Ilikemining1/HighAltitudeBallooningBoard/3D Render.png

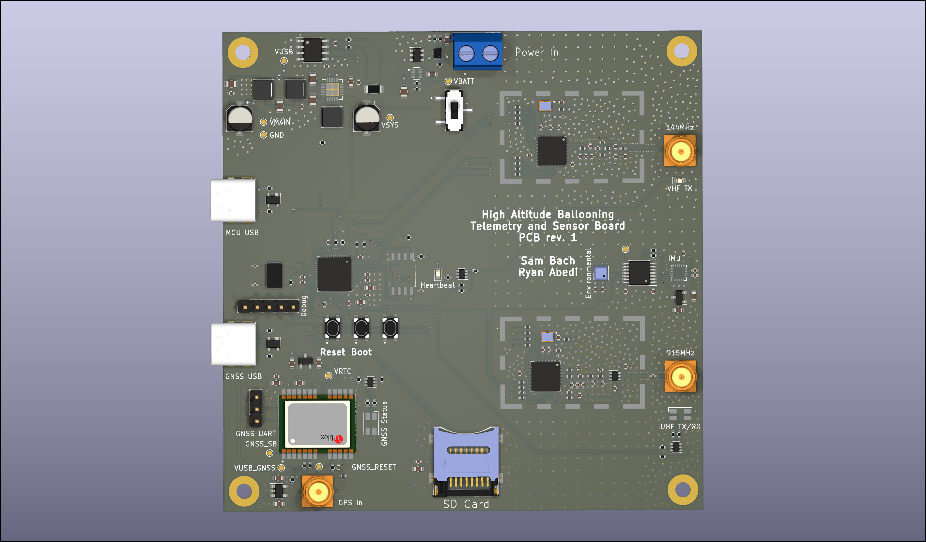
3D Render.png
