Ilikemining1/HighAltitudeBallooningBoard/HABBoard/I2C Bus Config.md

# I2C Bus Address Allocation

| Device	|	I<sup>2</sup>C Address |
|---|---|
| INA219 | 0x40 |
| NEO-M9N |	0x42 |
| BME688 | 0x77 |
| ICM-20948 | 0x69 |
