Ilikemining1/HighAltitudeBallooningBoard/HABBoard/3D/XFL4020-102MEC--3DModel-STEP-56544.STEP

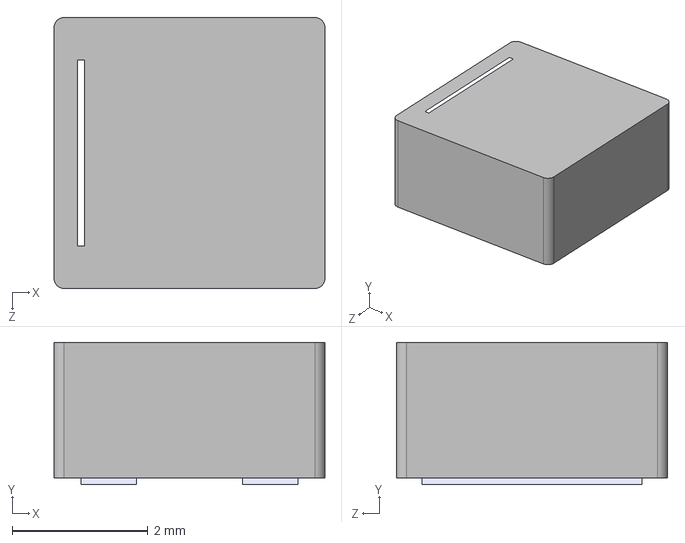
[picture p2: CAD file, 2023-02-09]
HABBoard/3D/XFL4020-102MEC--3DModel-STEP-56544.STEP
4.00 x 2.10 x 4.00 mm
