Ilikemining1/HighAltitudeBallooningBoard/HABBoard/3D/BME688--3DModel-STEP-56544.STEP

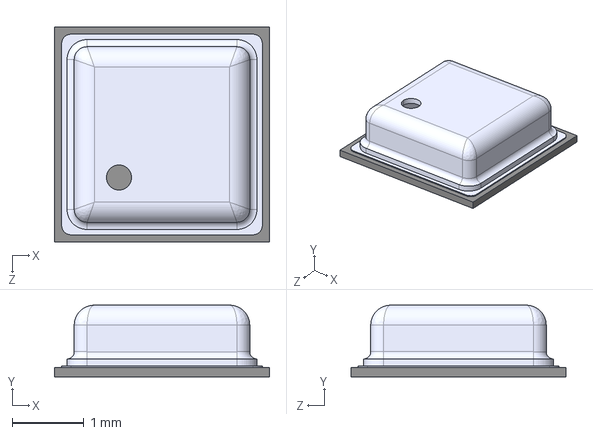
[picture p3: CAD file, 2023-02-09]
HABBoard/3D/BME688--3DModel-STEP-56544.STEP
3.00 x 1.00 x 3.00 mm
