Ilikemining1/HighAltitudeBallooningBoard/HABBoard/3D/USB4085-GF-A.stp

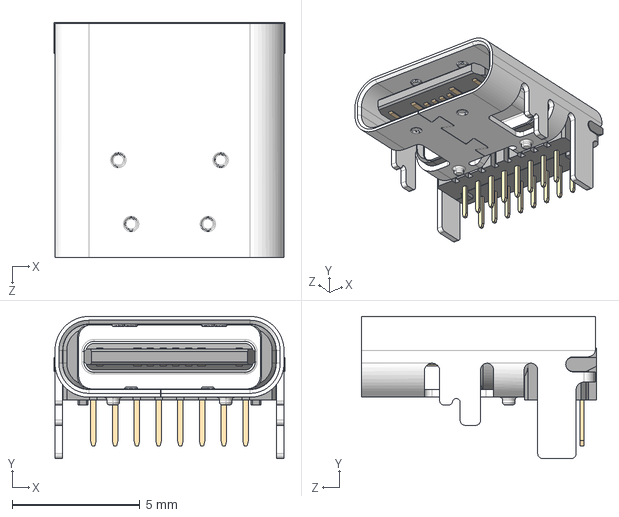
[picture p4: CAD file, 2023-02-08]
HABBoard/3D/USB4085-GF-A.stp
9.03 x 5.56 x 9.17 mm
housing_2
