Ilikemining1/HighAltitudeBallooningBoard/HABBoard/3D/CUI_DEVICES_TB002-500-02BE.step

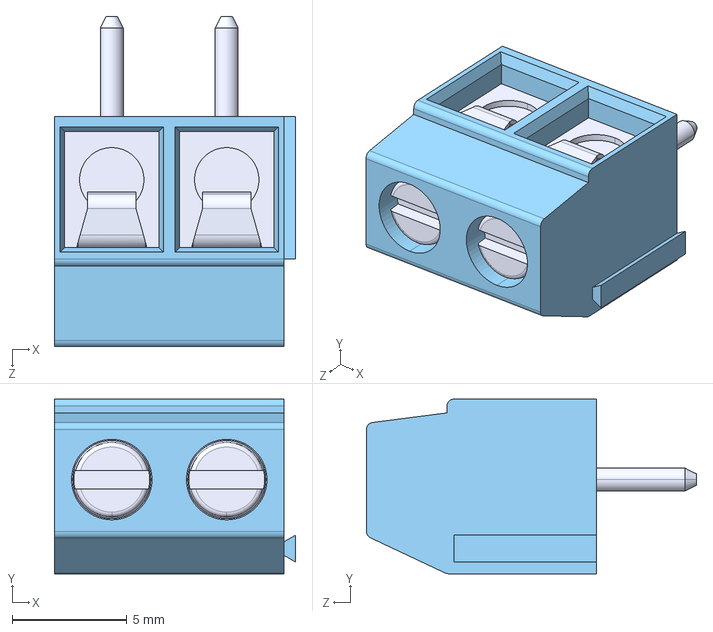
[picture p5: CAD file, 2023-02-07]
HABBoard/3D/CUI_DEVICES_TB002-500-02BE.step
10.5 x 7.60 x 14.4 mm
