Ilikemining1/HighAltitudeBallooningBoard/HABBoard/3D/SMA_CONNECTOR.step

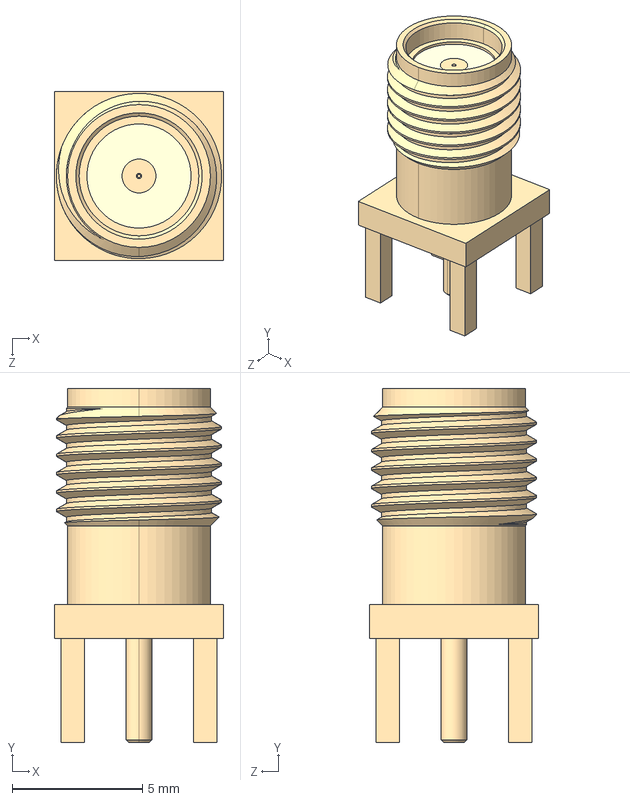
[picture p6: CAD file, 2023-02-07]
HABBoard/3D/SMA_CONNECTOR.step
6.50 x 13.6 x 6.50 mm
