Ilikemining1/HighAltitudeBallooningBoard/HABBoard/3D/445C25D12M00000.stp

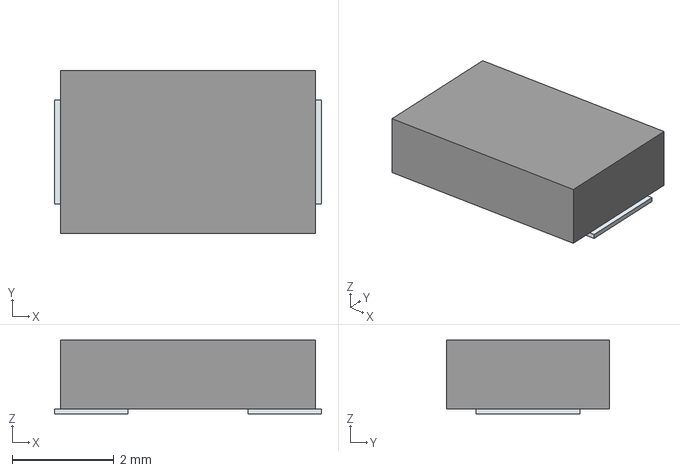
[picture p7: CAD file, 2023-02-06]
HABBoard/3D/445C25D12M00000.stp
5.24 x 3.20 x 1.45 mm
Pins
