Ilikemining1/HighAltitudeBallooningBoard/HABBoard/3D/u-blox_-_NEO-M9N-00B.step

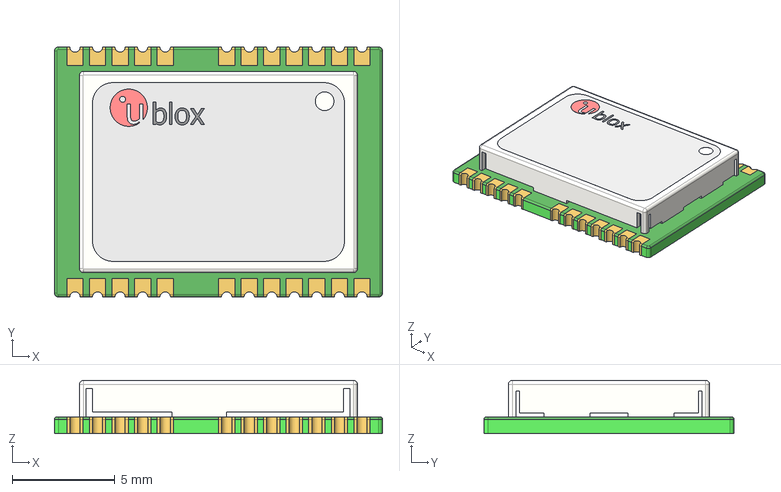
[picture p8: CAD file, 2023-02-06]
HABBoard/3D/u-blox_-_NEO-M9N-00B.step
16.0 x 12.2 x 2.60 mm
