Ilikemining1/HighAltitudeBallooningBoard/HABBoard/3D/PTS815_SJK_250_SMTR_LFS.stp

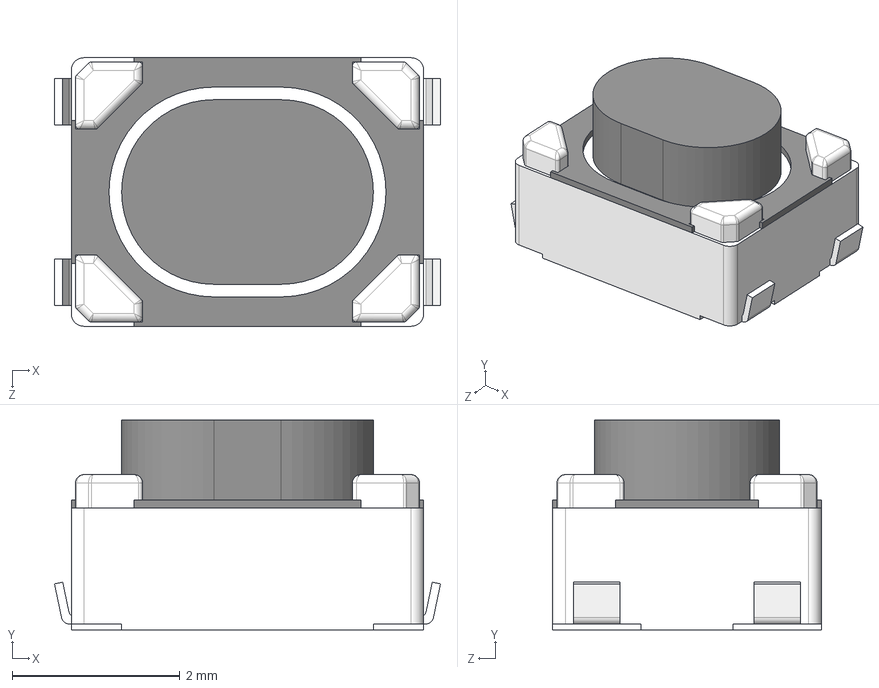
[picture p9: CAD file, 2023-02-06]
HABBoard/3D/PTS815_SJK_250_SMTR_LFS.stp
4.60 x 2.50 x 3.20 mm
