Ilikemining1/HighAltitudeBallooningBoard/HABBoard/3D/MP5016GQH.step

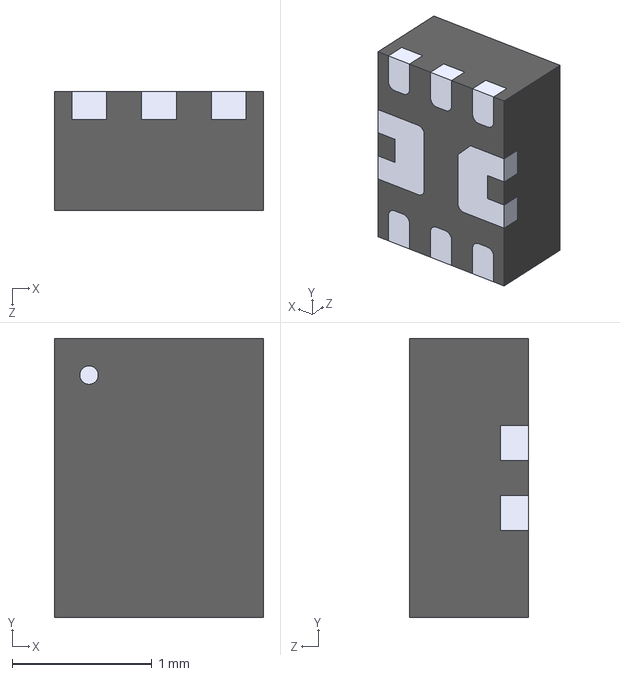
[picture p10: CAD file, 2023-02-06]
HABBoard/3D/MP5016GQH.step
1.50 x 2.00 x 0.85 mm
