Ilikemining1/HighAltitudeBallooningBoard/HABBoard/3D/MEM2067-02-180-00-A_REVB.step

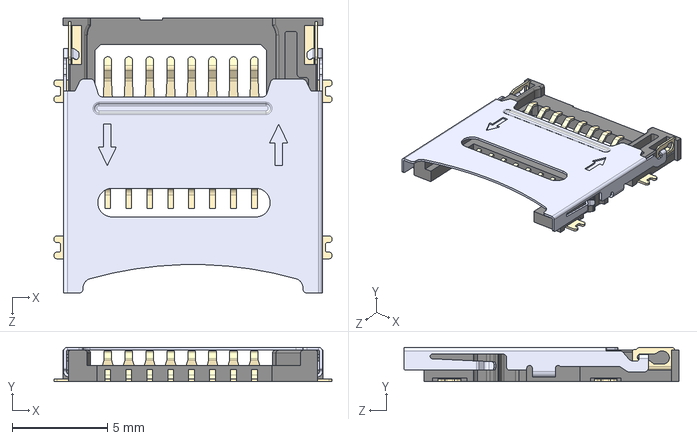
[picture p11: CAD file, 2023-02-05]
HABBoard/3D/MEM2067-02-180-00-A_REVB.step
14.6 x 1.80 x 14.5 mm
