Ilikemining1/HighAltitudeBallooningBoard/HABBoard/3D/ECS-TXO-25CSMV-320-BM-TR.step

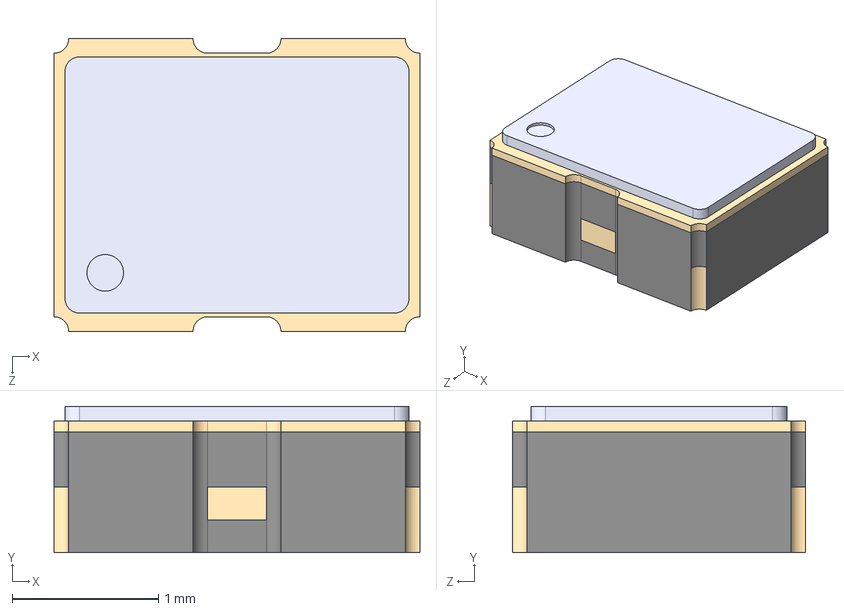
[picture p12: CAD file, 2023-01-26]
HABBoard/3D/ECS-TXO-25CSMV-320-BM-TR.step
2.50 x 1.00 x 2.00 mm
