Ilikemining1/HighAltitudeBallooningBoard/HABBoard/3D/JS102011SCQN.step

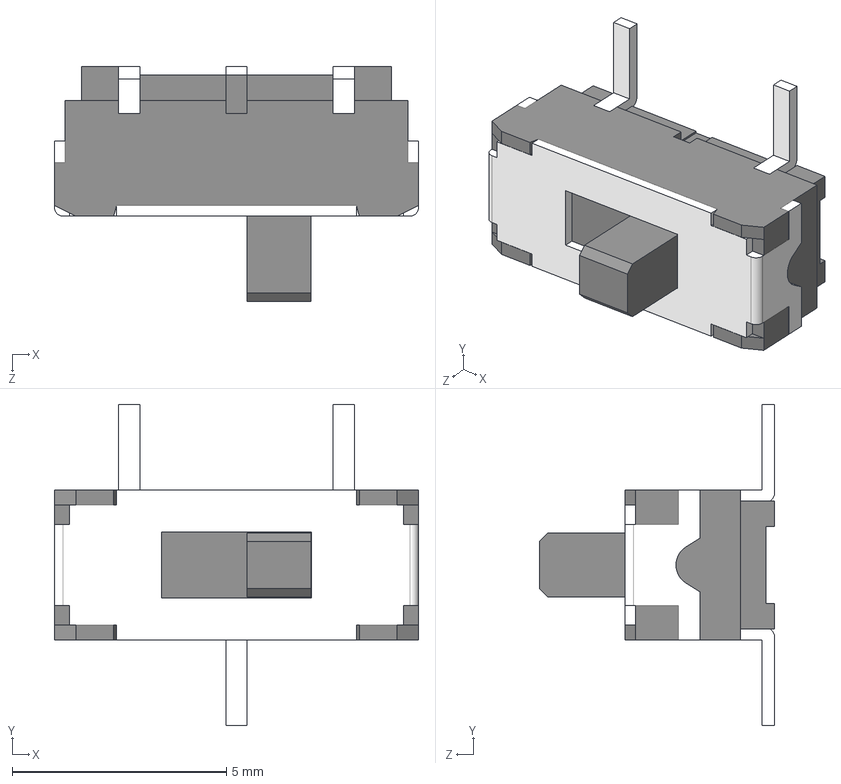
[picture p13: CAD file, 2023-02-05]
HABBoard/3D/JS102011SCQN.step
8.50 x 7.50 x 5.50 mm
