Ilikemining1/HighAltitudeBallooningBoard/Board Copper.pdf

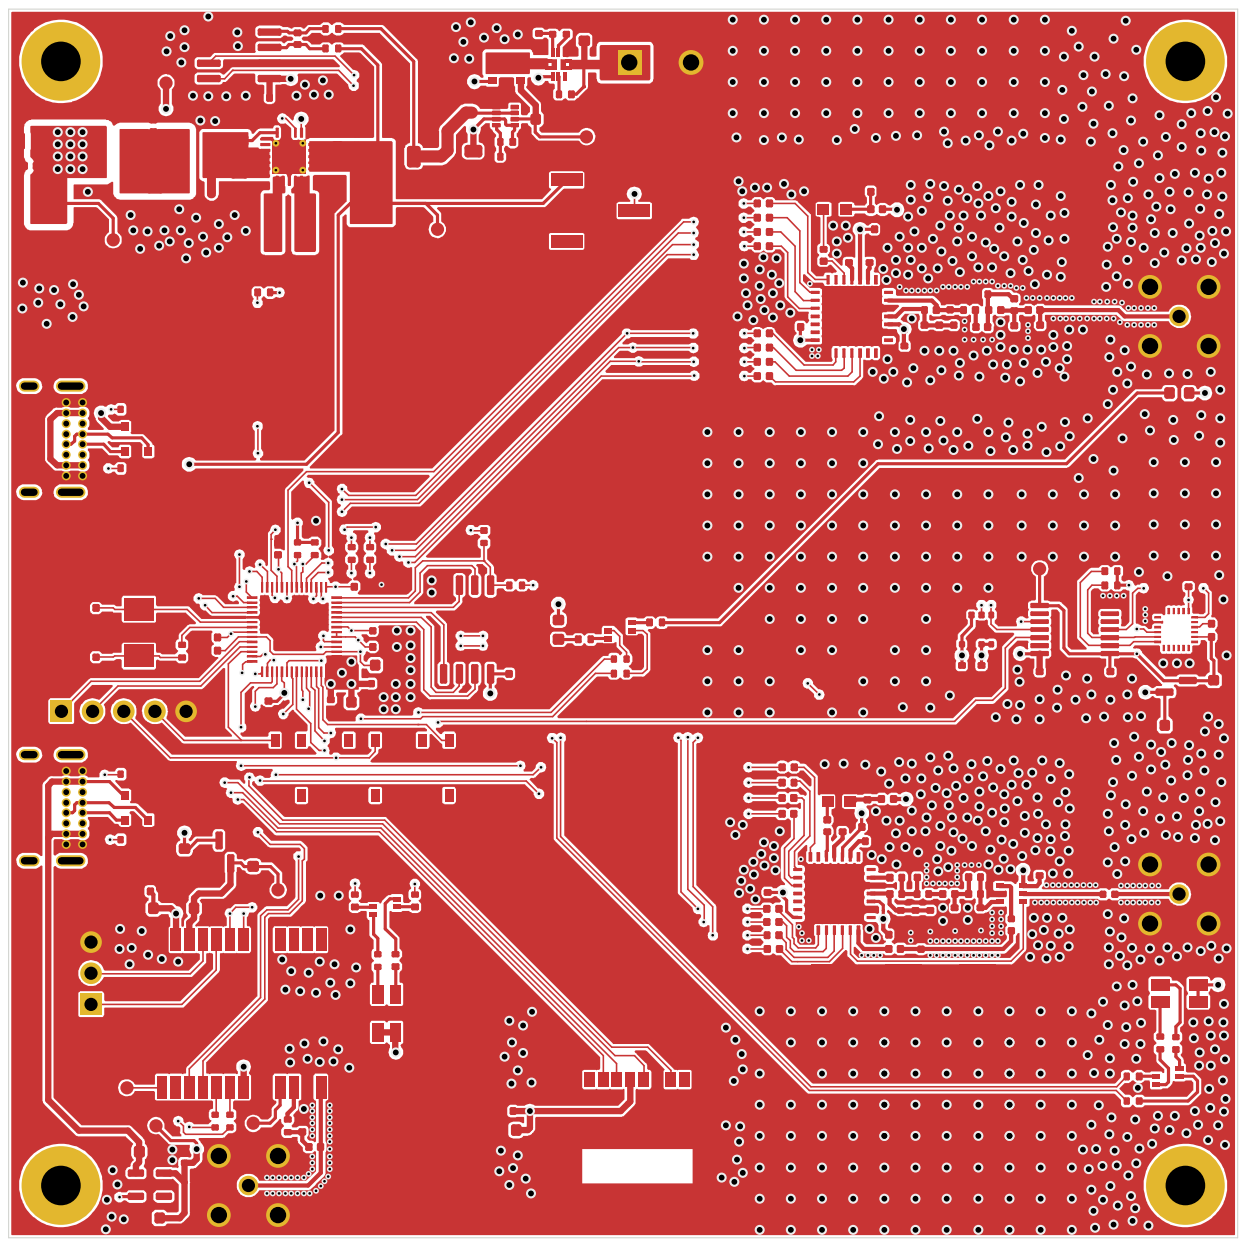
[picture p15: page 1]

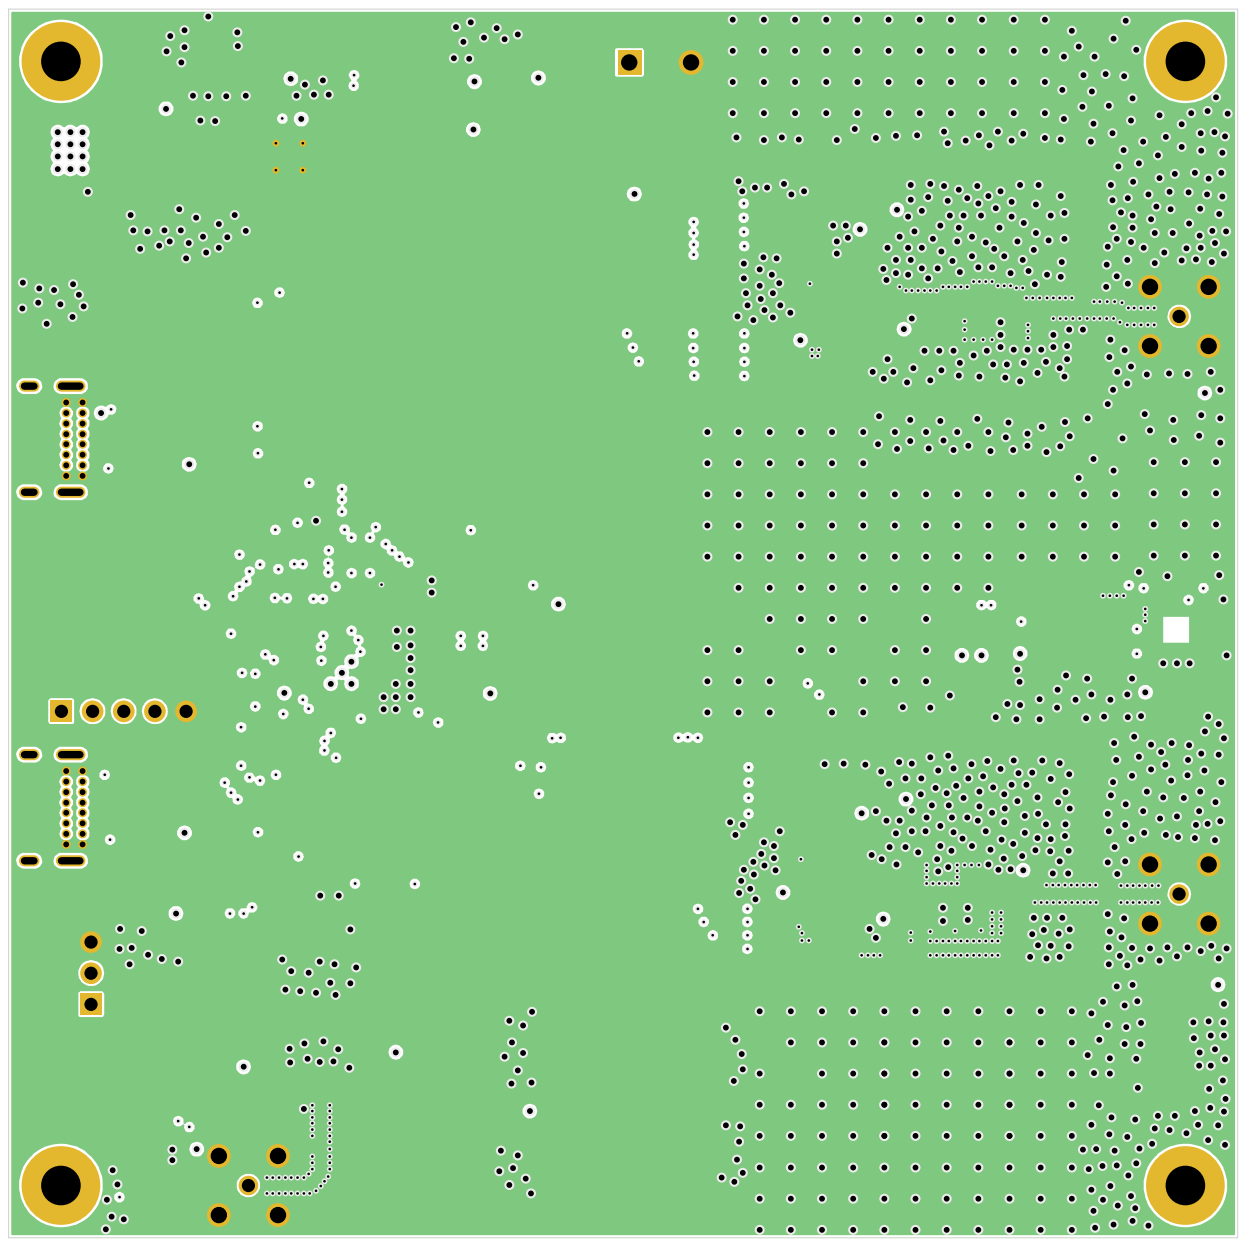
[picture p16: page 2]

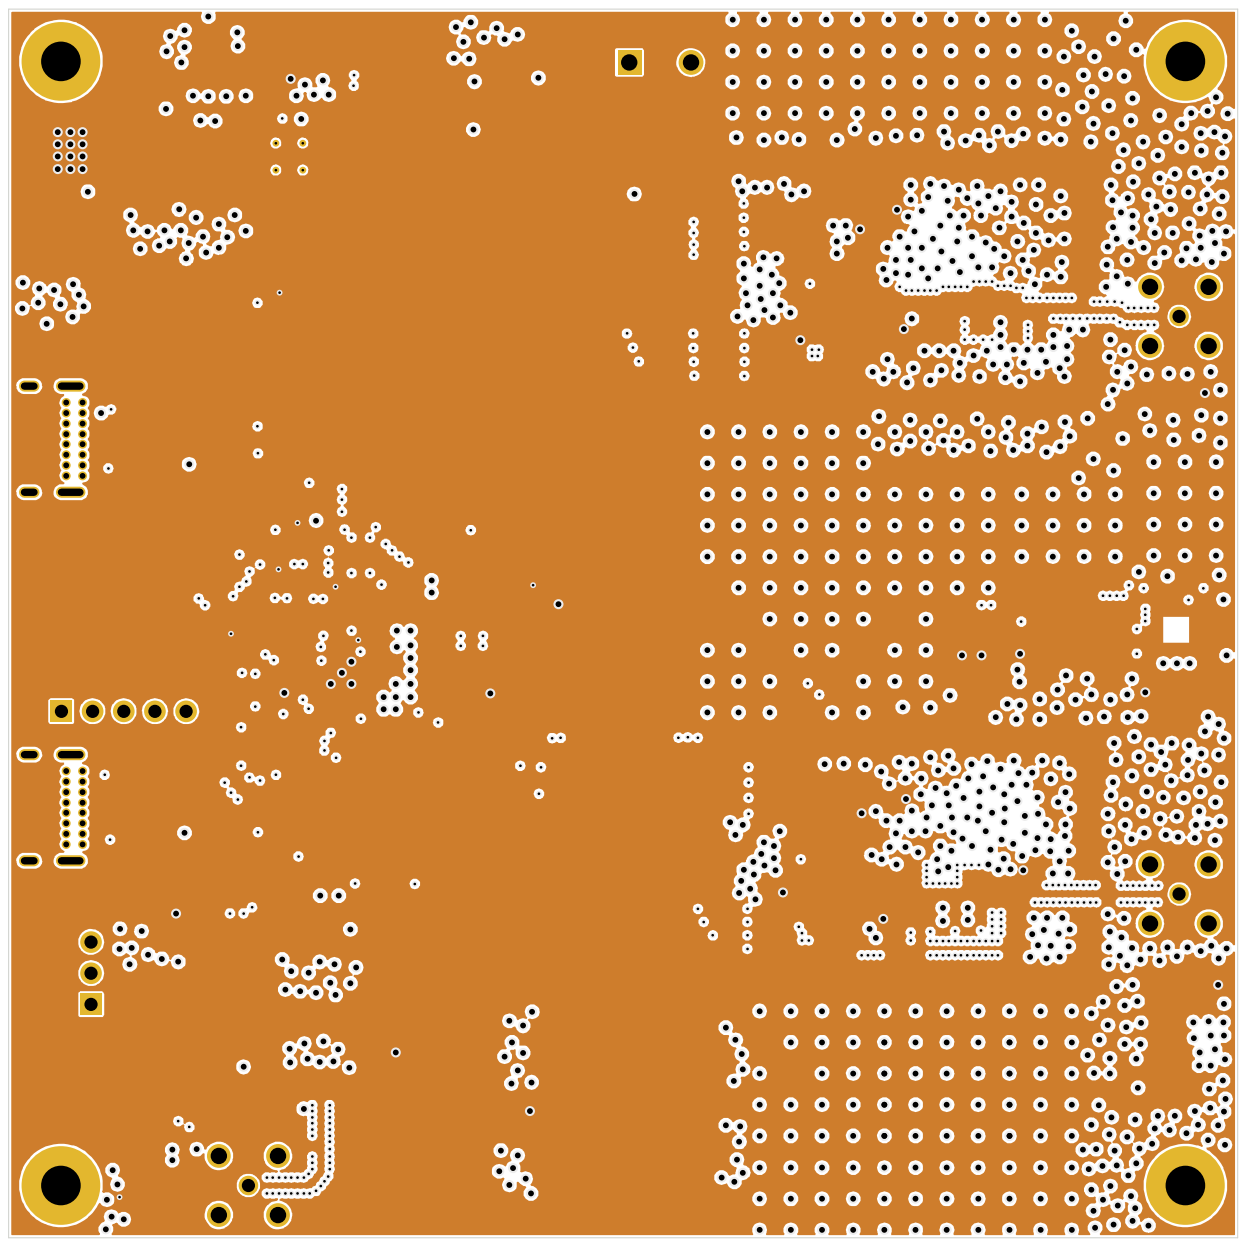
[picture p17: page 3]

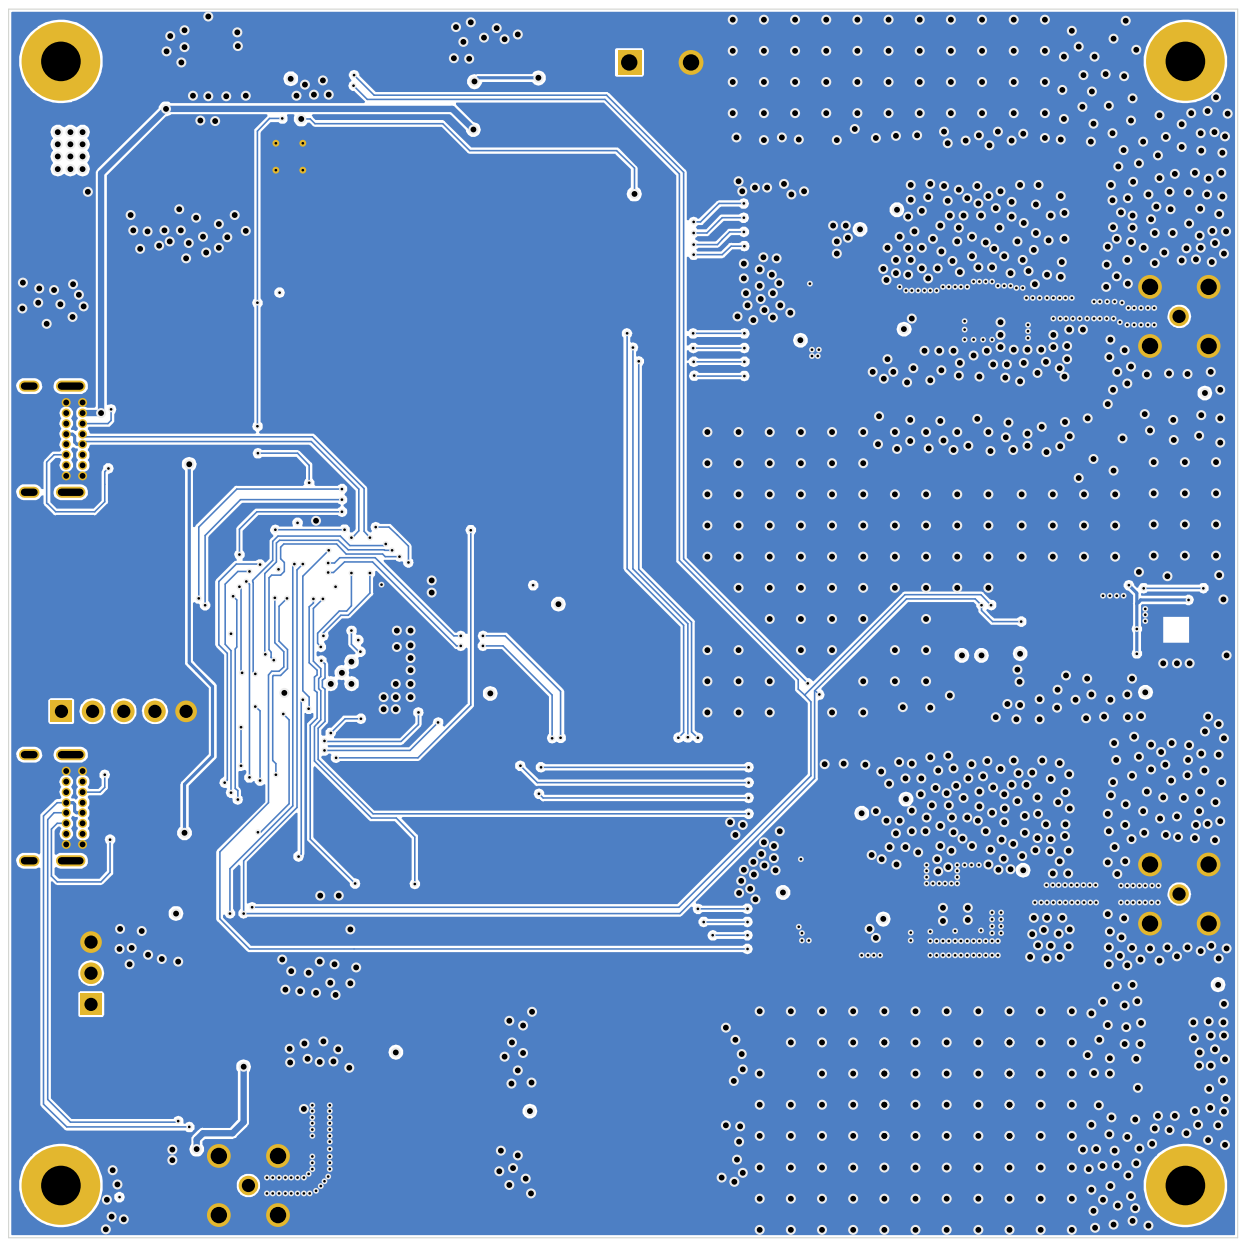
[picture p18: page 4]
