Ilikemining1/HighAltitudeBallooningBoard/HABBoard/HABBoard.kicad_pcb

## KiCad design HABBoard/HABBoard.kicad_pcb (2023-02-28)

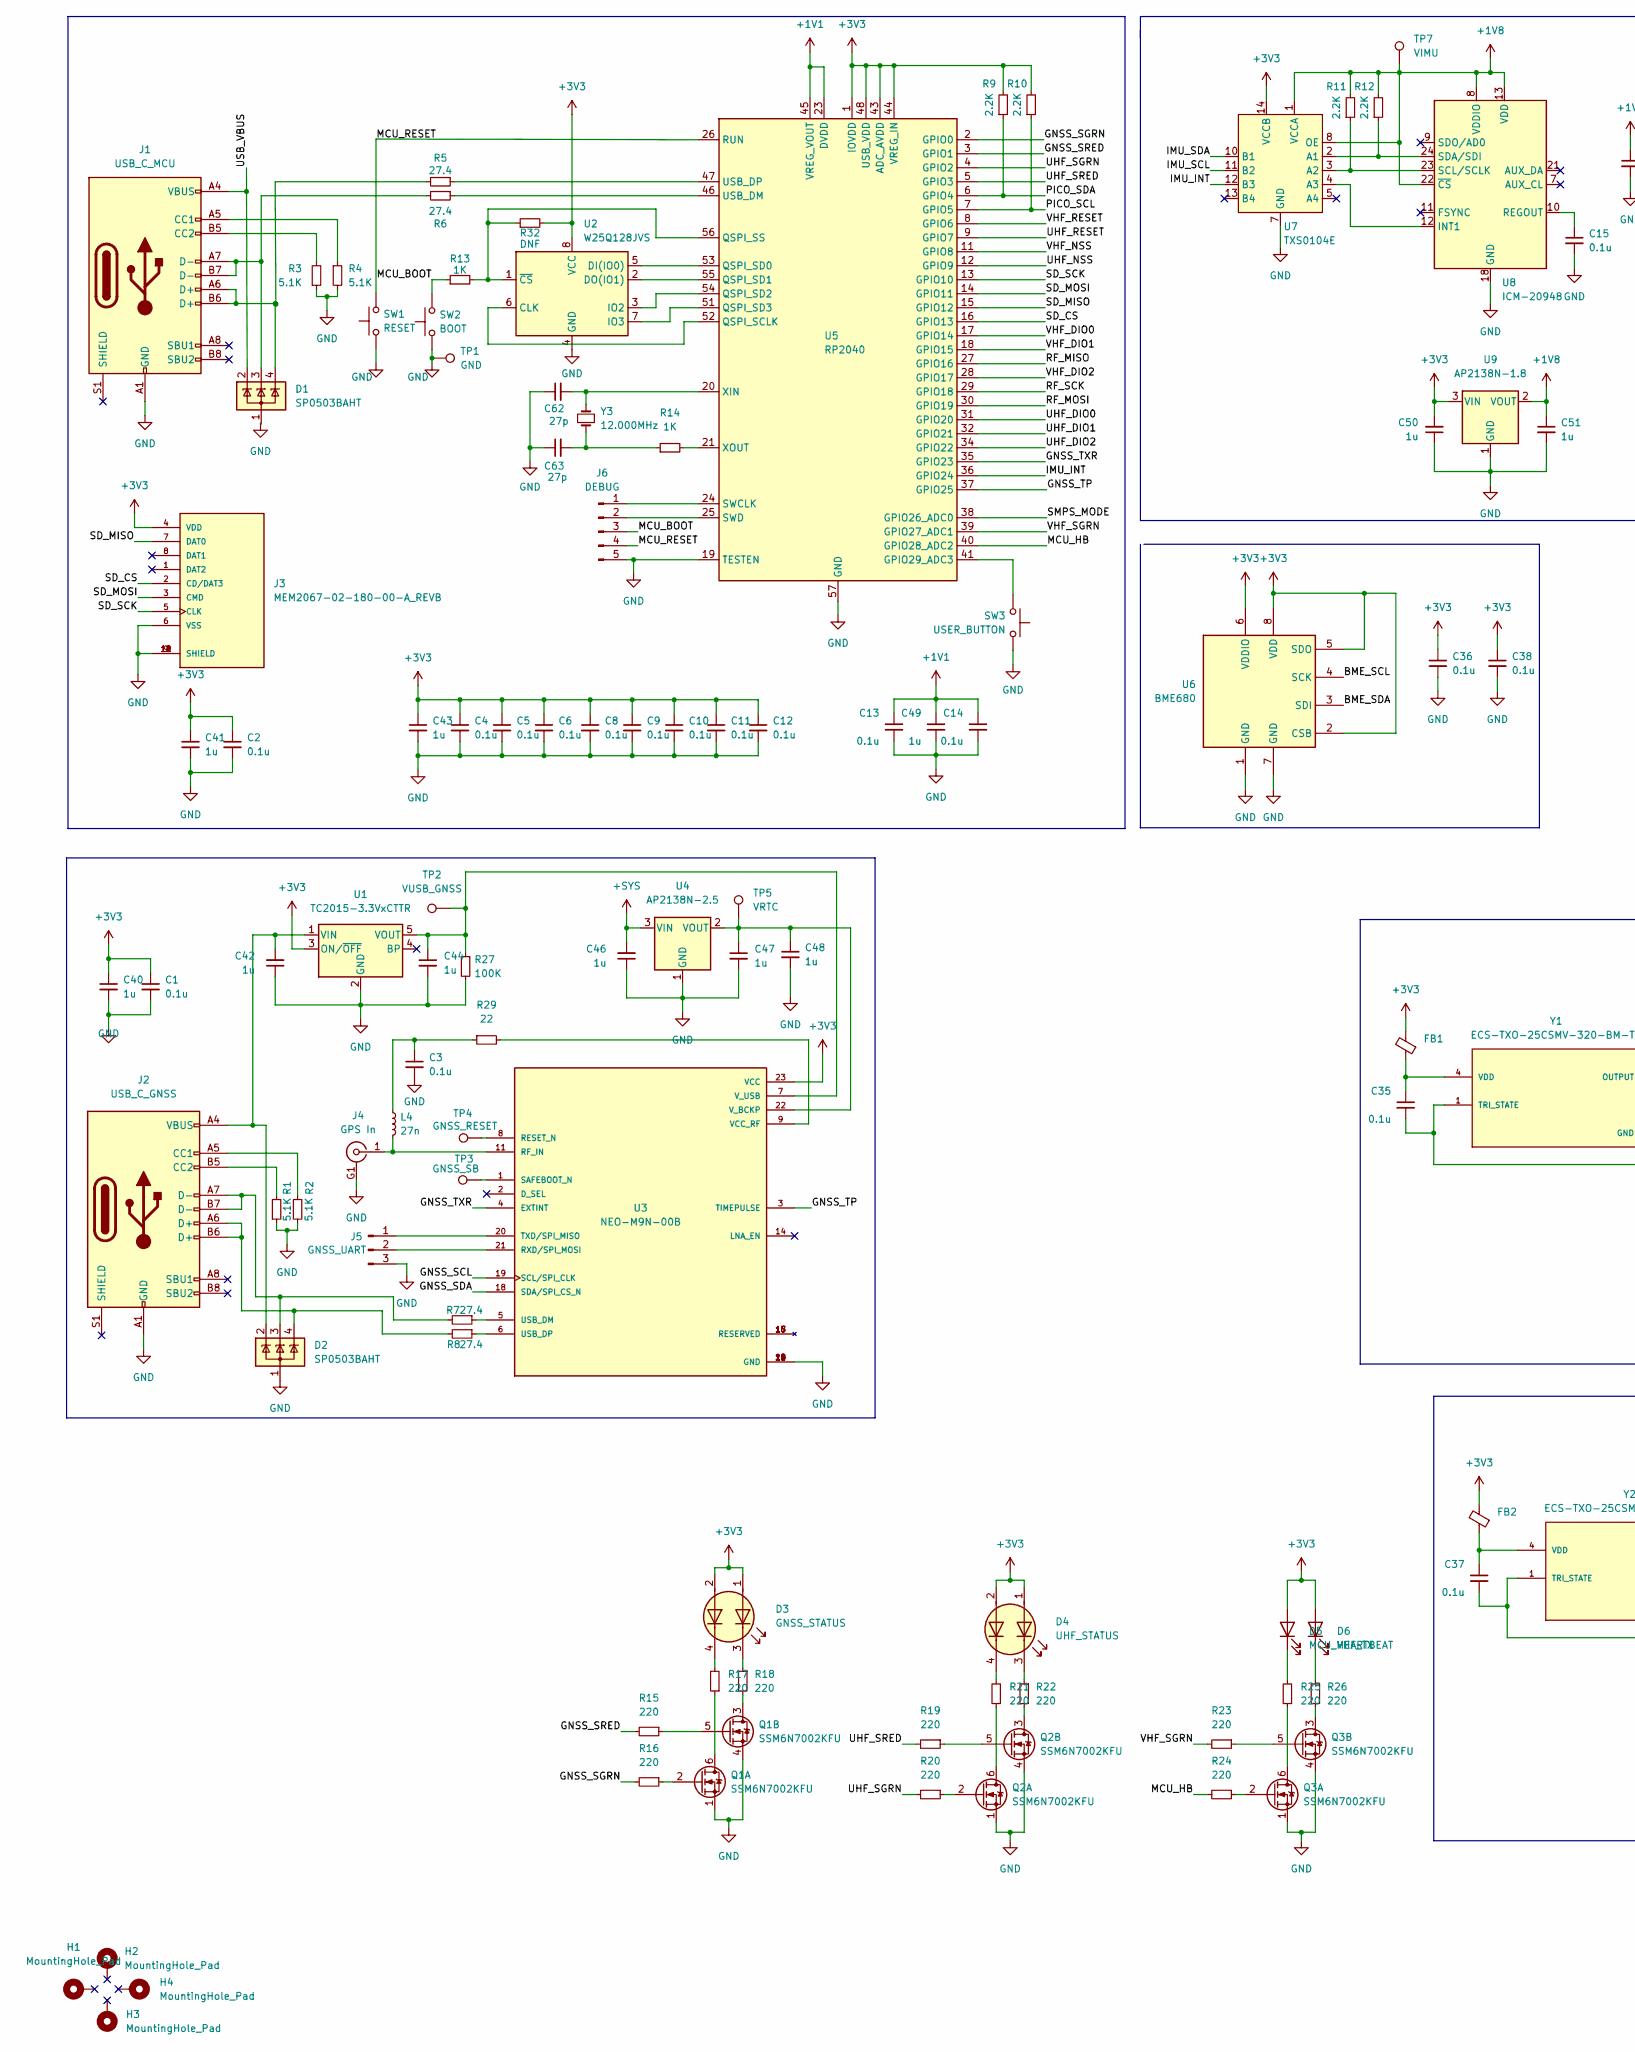
[picture p19: schematic HABBoard.kicad_sch, part in row 1, column 1]

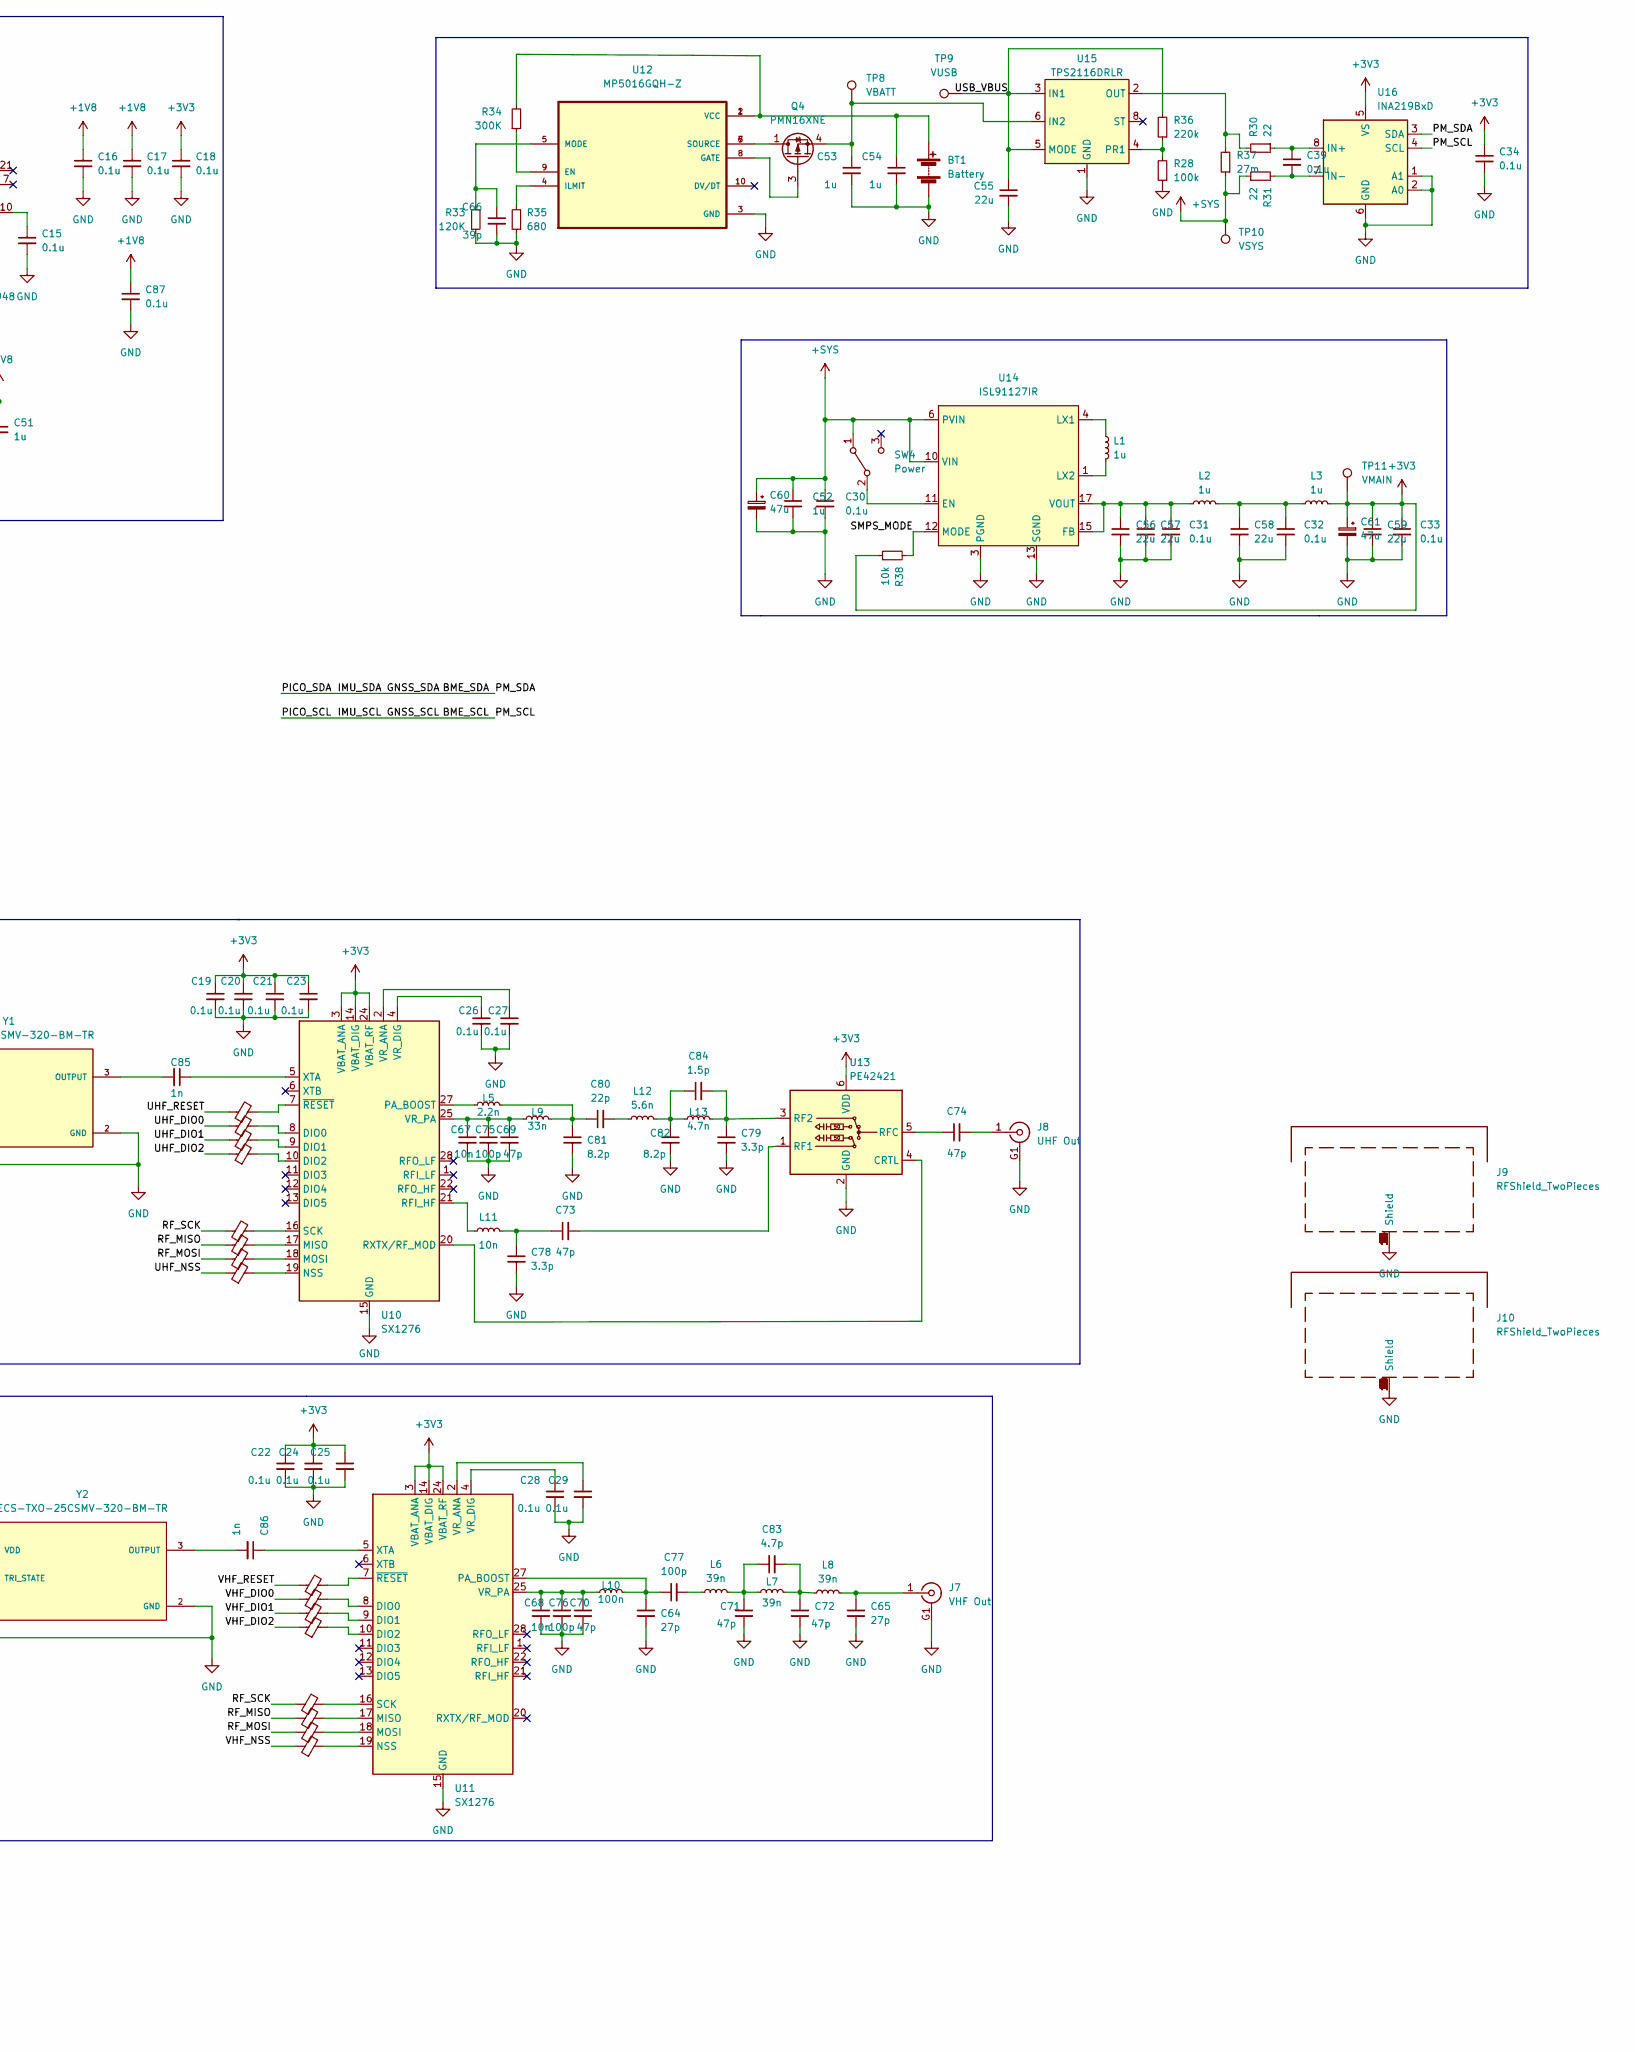
[picture p20: schematic HABBoard.kicad_sch, part in row 1, column 2]

Parts:
BT1: Battery; CUI_TB002-500-02BE
C1, C2, C3, C4, C5, C6, C8, C9, C10, C11, C12, C13, C14, C15, C16, C17, C18, C19, C20, C21, C22, C23, C24, C25, C26, C27, C28, C29, C30, C31, C32, C33, C34, C35, C36, C37, C38, C39, C87: 0.1u; C_0402_1005Metric
C40, C41, C42, C43, C44, C46, C47, C48, C49, C50, C51, C52, C53, C54: 1u; C_0603_1608Metric
C55, C56, C57, C58, C59: 22u; C_0805_2012Metric
C60, C61: 47u; CP_Elec_5x5.3
C62, C63, C64, C65: 27p; C_0402_1005Metric
C66: 39p; C_0402_1005Metric
C67, C68: 10n; C_0402_1005Metric
C69, C70, C71, C72, C73, C74: 47p; C_0402_1005Metric
C75, C76, C77: 100p; C_0402_1005Metric
C78, C79: 3.3p; C_0402_1005Metric
C80: 22p; C_0402_1005Metric
C81, C82: 8.2p; C_0402_1005Metric
C83: 4.7p; C_0402_1005Metric
C84: 1.5p; C_0402_1005Metric
C85, C86: 1n; C_0402_1005Metric
D1, D2: SP0503BAHT; SOT-143
D3: GNSS_STATUS; LED_RGB_Wuerth-PLCC4_3.2x2.8mm_150141M173100
D4: UHF_STATUS; LED_RGB_Wuerth-PLCC4_3.2x2.8mm_150141M173100
D5: MCU_HEARTBEAT; LED_0603_1608Metric
D6: VHF_TX; LED_0603_1608Metric
FB1, FB2, FB3, FB4, FB5, FB7, FB8, FB9, FB10, FB11, FB12, FB13, FB14, FB15, FB16, FB17, FB18: FerriteBead_Small; L_0402_1005Metric
FB6: FB; L_0402_1005Metric
H1, H2, H3, H4: MountingHole_Pad; MountingHole_3.2mm_M3_Pad
J1: USB_C_MCU; USB_C_Receptacle_GCT_USB4085
J2: USB_C_GNSS; USB_C_Receptacle_GCT_USB4085
J3: MEM2067-02-180-00-A_REVB; GCT_MEM2067-02-180-00-A_REVB
J4: GPS In; LPRS_SMA_CONNECTOR
J5: GNSS_UART; PinHeader_1x03_P2.54mm_Vertical
J6: DEBUG; PinHeader_1x05_P2.54mm_Vertical
J7: VHF Out; LPRS_SMA_CONNECTOR
J8: UHF Out; LPRS_SMA_CONNECTOR
J9, J10: RFShield_TwoPieces; SMS409F
L1, L2, L3: 1u; L_Coilcraft_XxL4020
L4: 27n; L_0402_1005Metric
L5: 2.2n; L_0402_1005Metric
L6, L7, L8: 39n; L_0402_1005Metric
L9: 33n; L_0402_1005Metric
L10: 100n; L_0402_1005Metric
L11: 10n; L_0402_1005Metric
L12: 5.6n; L_0402_1005Metric
L13: 4.7n; L_0402_1005Metric
Q1, Q2, Q3: SSM6N7002KFU; SOT-363_SC-70-6
Q4: PMN16XNE; TSOP-6_1.65x3.05mm_P0.95mm
R1, R2, R3, R4: 5.1K; R_0402_1005Metric
R5, R6, R7, R8: 27.4; R_0402_1005Metric
R9, R10, R11, R12: 2.2K; R_0402_1005Metric
R13, R14: 1K; R_0402_1005Metric
R15, R16, R17, R18, R19, R20, R21, R22, R23, R24, R25, R26: 220; R_0402_1005Metric
R27: 100K; R_0402_1005Metric
R28: 100k; R_0402_1005Metric
R29, R30, R31: 22; R_0402_1005Metric
R32: DNF; R_0402_1005Metric
R33: 120K; R_0402_1005Metric
R34: 300K; R_0402_1005Metric
R35: 680; R_0402_1005Metric
R36: 220k; R_0402_1005Metric
R37: 27m; R_1206_3216Metric
R38: 10k; R_0402_1005Metric
SW1: RESET; PTS815SJK250SMTRLFS
SW2: BOOT; PTS815SJK250SMTRLFS
SW3: USER_BUTTON; PTS815SJK250SMTRLFS
SW4: Power; SW_JS102011SCQN
TP1: GND; TestPoint_Pad_D1.0mm
TP2: VUSB_GNSS; TestPoint_Pad_D1.0mm
TP3: GNSS_SB; TestPoint_Pad_D1.0mm
TP4: GNSS_RESET; TestPoint_Pad_D1.0mm
TP5: VRTC; TestPoint_Pad_D1.0mm
TP7: VIMU; TestPoint_Pad_D1.0mm
TP8: VBATT; TestPoint_Pad_D1.0mm
TP9: VUSB; TestPoint_Pad_D1.0mm
TP10: VSYS; TestPoint_Pad_D1.0mm
TP11: VMAIN; TestPoint_Pad_D1.0mm
U1: TC2015-3.3VxCTTR; SOT-23-5
U2: W25Q128JVS; SOIC-8_5.23x5.23mm_P1.27mm
U3: NEO-M9N-00B; XCVR_NEO-M9N-00B
U4: AP2138N-2.5; SOT-23
U5: RP2040; QFN-56-1EP_7x7mm_P0.4mm_EP3.2x3.2mm
U6: BME680; Bosch_LGA-8_3x3mm_P0.8mm_ClockwisePinNumbering
U7: TXS0104E; TSSOP-14_4.4x5mm_P0.65mm
U8: ICM-20948; InvenSense_QFN-24_3x3mm_P0.4mm
U9: AP2138N-1.8; SOT-23
U10, U11: SX1276; QFN-28-1EP_6x6mm_P0.65mm_EP4.8x4.8mm
U12: MP5016GQH-Z
U13: PE42421; SOT-363_SC-70-6
U14: ISL91127IR; QFN-20-1EP_4x4mm_P0.5mm_EP2.7x2.7mm_ThermalVias
U15: TPS2116DRLR; SOTFL50P160X60-8N
U16: INA219BxD; SOIC-8_3.9x4.9mm_P1.27mm
Y1, Y2: ECS-TXO-25CSMV-320-BM-TR; OSC_ECS-TXO-25CSMV-320-BM-TR
Y3: 12.000MHz; 445C25D12M00000

Connections:
+1V1: C13.1, C14.1, C49.1, U5.23 (DVDD), U5.45 (VREG_VOUT), U5.50 (DVDD)
+1V8: C16.1, C17.1, C51.1, C87.1, R11.2, R12.2, TP7.1, U7.1 (VCCA), U7.8 (OE), U8.8 (VDDIO), U8.13 (VDD), U8.22 (~CS), U9.2 (VOUT)
+3V3: C1.1, C2.1, C4.1, C5.1, C6.1, C8.1, C9.1, C10.1, C11.1, C12.1, C18.1, C19.1, C20.1, C21.1, C22.1, C23.1, C24.1, C25.1, C33.1, C34.1, C36.1, C38.1, C40.1, C41.1, C43.1, C50.2, C59.1, C61.1, D3.1 (A1), D3.2 (A2), D4.1 (A1), D4.2 (A2), D5.2 (A), D6.2 (A), FB1.2, FB2.2, J3.4 (VDD), L3.2, R9.2, R10.2, R32.2, R38.1, TP11.1, U1.3 (ON/~OFF), U2.8 (VCC), U3.23 (VCC), U5.1 (IOVDD), U5.10 (IOVDD), U5.22 (IOVDD), U5.33 (IOVDD), U5.42 (IOVDD), U5.43 (ADC_AVDD), U5.44 (VREG_IN), U5.48 (USB_VDD), U5.49 (IOVDD), U6.2 (CSB), U6.5 (SDO), U6.6 (VDDIO), U6.8 (VDD), U7.14 (VCCB), U9.3 (VIN), U10.3 (VBAT_ANA), U10.14 (VBAT_DIG), U10.24 (VBAT_RF), U11.3 (VBAT_ANA), U11.14 (VBAT_DIG), U11.24 (VBAT_RF), U13.6 (VDD), U16.5 (VS)
+SYS: C30.1, C46.2, C52.1, C60.1, R31.1, R37.1, SW4.1 (A), TP10.1, U4.3 (VIN), U14.6 (PVIN), U14.7 (PVIN), U14.8 (PVIN), U14.9 (PVIN), U14.10 (VIN)
/BME_SCL: R10.1, U3.19 (SCL/SPI_CLK), U5.7 (GPIO5), U6.4 (SCK), U7.11 (B2), U16.4 (SCL)
/BME_SDA: R9.1, U3.18 (SDA/SPI_CS_N), U5.6 (GPIO4), U6.3 (SDI), U7.10 (B1), U16.3 (SDA)
/GNSS_SGRN: R16.2, U5.2 (GPIO0)
/GNSS_SRED: R15.2, U5.3 (GPIO1)
/GNSS_TP: U3.3 (TIMEPULSE), U5.37 (GPIO25)
/GNSS_TXR: U3.4 (EXTINT), U5.35 (GPIO23)
/IMU_INT: U5.36 (GPIO24), U7.12 (B3)
/MCU_BOOT: J6.3, R13.1, SW2.2
/MCU_HB: R24.2, U5.40 (GPIO28_ADC2)
/MCU_RESET: J6.4, SW1.2, U5.26 (RUN)
/RF_MISO: FB4.1, FB12.1, U5.27 (GPIO16)
/RF_MOSI: FB5.1, FB13.1, U5.30 (GPIO19)
/RF_SCK: FB3.1, FB11.1, U5.29 (GPIO18)
/SD_CS: J3.2 (CD/DAT3), U5.16 (GPIO13)
/SD_MISO: J3.7 (DAT0), U5.15 (GPIO12)
/SD_MOSI: J3.3 (CMD), U5.14 (GPIO11)
/SD_SCK: J3.5 (CLK), U5.13 (GPIO10)
/SMPS_MODE: R38.2, U5.38 (GPIO26_ADC0), U14.12 (MODE)
/UHF_DIO0: FB8.1, U5.31 (GPIO20)
/UHF_DIO1: FB9.1, U5.32 (GPIO21)
/UHF_DIO2: FB10.1, U5.34 (GPIO22)
/UHF_NSS: FB6.1, U5.12 (GPIO9)
/UHF_RESET: FB7.1, U5.9 (GPIO7)
/UHF_SGRN: R20.2, U5.4 (GPIO2)
/UHF_SRED: R19.2, U5.5 (GPIO3)
/USB_VBUS: C55.1, D1.2 (K), J1.A4 (VBUS), J1.A9 (VBUS), J1.B4 (VBUS), J1.B9 (VBUS), R36.2, TP9.1, U15.3 (IN1), U15.5 (MODE)
/VHF_DIO0: FB16.1, U5.17 (GPIO14)
/VHF_DIO1: FB17.1, U5.18 (GPIO15)
/VHF_DIO2: FB18.1, U5.28 (GPIO17)
/VHF_NSS: FB14.1, U5.11 (GPIO8)
/VHF_RESET: FB15.1, U5.8 (GPIO6)
/VHF_SGRN: R23.2, U5.39 (GPIO27_ADC1)
GND: BT1.2 (-), C1.2, C2.2, C3.2, C4.2, C5.2, C6.2, C8.2, C9.2, C10.2, C11.2, C12.2, C13.2, C14.2, C15.2, C16.2, C17.2, C18.2, C19.2, C20.2, C21.2, C22.2, C23.2, C24.2, C25.2, C26.2, C27.2, C28.2, C29.2, C30.2, C31.2, C32.2, C33.2, C34.2, C35.2, C36.2, C37.2, C38.2, C40.2, C41.2, C42.1, C43.2, C44.2, C46.1, C47.2, C48.2, C49.2, C50.1, C51.2, C52.2, C53.2, C54.2, C55.2, C56.2, C57.2, C58.2, C59.2, C60.2, C61.2, C62.1, C63.1, C64.2, C65.2, C66.2, C67.2, C68.2, C69.2, C70.2, C71.2, C72.2, C75.2, C76.2, C78.2, C79.2, C81.2, C82.2, C87.2, D1.1 (A), D2.1 (A), J1.A1 (GND), J1.A12 (GND), J1.B1 (GND), J1.B12 (GND), J2.A1 (GND), J2.A12 (GND), J2.B1 (GND), J2.B12 (GND), J3.6 (VSS), J3.9 (SHIELD), J3.10 (SHIELD), J3.11 (SHIELD), J3.12 (SHIELD), J4.G1 (Ext), J4.G2 (Ext), J4.G3 (Ext), J4.G4 (Ext), J5.3, J6.5, J7.G1 (Ext), J7.G2 (Ext), J7.G3 (Ext), J7.G4 (Ext), J8.G1 (Ext), J8.G2 (Ext), J8.G3 (Ext), J8.G4 (Ext), J9.1 (Shield), J9.2 (Shield), J9.3 (Shield), J9.4 (Shield), J9.5 (Shield), J9.6 (Shield), J9.7 (Shield), J9.8 (Shield), J9.9 (Shield), J9.10 (Shield), J9.11 (Shield), J9.12 (Shield), J9.13 (Shield), J9.14 (Shield), J9.15 (Shield), J9.16 (Shield), J10.1 (Shield), J10.2 (Shield), J10.3 (Shield), J10.4 (Shield), J10.5 (Shield), J10.6 (Shield), J10.7 (Shield), J10.8 (Shield), J10.9 (Shield), J10.10 (Shield), J10.11 (Shield), J10.12 (Shield), J10.13 (Shield), J10.14 (Shield), J10.15 (Shield), J10.16 (Shield), Q1.1 (S), Q1.4 (S), Q2.1 (S), Q2.4 (S), Q3.1 (S), Q3.4 (S), R1.1, R2.2, R3.1, R4.2, R27.2, R28.1, R33.1, R35.1, SW1.1, SW2.1, SW3.1, TP1.1, U1.2 (GND), U2.4 (GND), U3.10 (GND), U3.12 (GND), U3.13 (GND), U3.24 (GND), U4.1 (GND), U5.19 (TESTEN), U5.57 (GND), U6.1 (GND), U6.7 (GND), U7.7 (GND), U8.18 (GND), U8.20 (GND), U9.1 (GND), U10.15 (GND), U10.23 (GND), U10.26 (GND), U10.29 (GND), U11.15 (GND), U11.23 (GND), U11.26 (GND), U11.29 (GND), U12.3 (GND), U13.2 (GND), U14.3 (PGND), U14.13 (SGND), U14.14 (SGND), U14.21 (PGND), U15.1 (GND), U16.1 (A1), U16.2 (A0), U16.6 (GND), Y1.1 (TRI_STATE), Y1.2 (GND), Y2.1 (TRI_STATE), Y2.2 (GND)
unnamed: BT1.1 (+), C54.1, R34.2, U12.1 (VCC), U12.2 (VCC)
unnamed: C3.1, L4.1, R29.1
unnamed: C15.1, U8.10 (REGOUT)
unnamed: C26.1, U10.4 (VR_DIG)
unnamed: C27.1, U10.2 (VR_ANA)
unnamed: C28.1, U11.4 (VR_DIG)
unnamed: C29.1, U11.2 (VR_ANA)
unnamed: C31.1, C56.1, C57.1, L2.1, U14.15 (FB), U14.17 (VOUT), U14.18 (VOUT), U14.19 (VOUT), U14.20 (VOUT)
unnamed: C32.1, C58.1, L2.2, L3.1
unnamed: C35.1, FB1.1, Y1.4 (VDD)
unnamed: C37.1, FB2.1, Y2.4 (VDD)
unnamed: C39.1, R30.1, U16.8 (IN+)
unnamed: C39.2, R31.2, U16.7 (IN-)
unnamed: C42.2, D2.2 (K), J2.A4 (VBUS), J2.A9 (VBUS), J2.B4 (VBUS), J2.B9 (VBUS), U1.1 (VIN)
unnamed: C44.1, R27.1, TP2.1, U1.5 (VOUT), U3.7 (V_USB)
unnamed: C47.1, C48.1, TP5.1, U3.22 (V_BCKP), U4.2 (VOUT)
unnamed: C53.1, Q4.4 (S), TP8.1, U15.6 (IN2)
unnamed: C62.2, U5.20 (XIN), Y3.2
unnamed: C63.2, R14.1, Y3.1
unnamed: C64.1, C77.1, L10.2, U11.27 (PA_BOOST)
unnamed: C65.1, J7.1 (In), L8.2
unnamed: C66.1, R33.2, U12.5 (MODE)
unnamed: C67.1, C69.1, C75.1, L9.1, U10.25 (VR_PA)
unnamed: C68.1, C70.1, C76.1, L10.1, U11.25 (VR_PA)
unnamed: C71.1, C83.1, L6.2, L7.1
unnamed: C72.1, C83.2, L7.2, L8.1
unnamed: C73.1, C78.1, L11.2
unnamed: C73.2, U13.1 (RF1)
unnamed: C74.1, U13.5 (RFC)
unnamed: C74.2, J8.1 (In)
unnamed: C77.2, L6.1
unnamed: C79.1, C84.2, L13.2, U13.3 (RF2)
unnamed: C80.1, C81.1, L5.2, L9.2
unnamed: C80.2, L12.1
unnamed: C82.1, C84.1, L12.2, L13.1
unnamed: C85.1, U10.5 (XTA)
unnamed: C85.2, Y1.3 (OUTPUT)
unnamed: C86.1, U11.5 (XTA)
unnamed: C86.2, Y2.3 (OUTPUT)
unnamed: D1.3 (K), J1.A7 (D-), J1.B7 (D-), R6.2
unnamed: D1.4 (K), J1.A6 (D+), J1.B6 (D+), R5.2
unnamed: D2.3 (K), J2.A7 (D-), J2.B7 (D-), R7.2
unnamed: D2.4 (K), J2.A6 (D+), J2.B6 (D+), R8.2
unnamed: D3.3 (K1), R18.1
unnamed: D3.4 (K2), R17.2
unnamed: D4.3 (K1), R22.1
unnamed: D4.4 (K2), R21.2
unnamed: D5.1 (K), R25.2
unnamed: D6.1 (K), R26.1
unnamed: FB3.2, U10.16 (SCK)
unnamed: FB4.2, U10.17 (MISO)
unnamed: FB5.2, U10.18 (MOSI)
unnamed: FB6.2, U10.19 (NSS)
unnamed: FB7.2, U10.7 (~RESET)
unnamed: FB8.2, U10.8 (DIO0)
unnamed: FB9.2, U10.9 (DIO1)
unnamed: FB10.2, U10.10 (DIO2)
unnamed: FB11.2, U11.16 (SCK)
unnamed: FB12.2, U11.17 (MISO)
unnamed: FB13.2, U11.18 (MOSI)
unnamed: FB14.2, U11.19 (NSS)
unnamed: FB15.2, U11.7 (~RESET)
unnamed: FB16.2, U11.8 (DIO0)
unnamed: FB17.2, U11.9 (DIO1)
unnamed: FB18.2, U11.10 (DIO2)
unnamed: J1.A5 (CC1), R4.1
unnamed: J1.B5 (CC2), R3.2
unnamed: J2.A5 (CC1), R2.1
unnamed: J2.B5 (CC2), R1.2
unnamed: J4.1 (In), L4.2, U3.11 (RF_IN)
unnamed: J5.1, U3.20 (TXD/SPI_MISO)
unnamed: J5.2, U3.21 (RXD/SPI_MOSI)
unnamed: J6.1, U5.24 (SWCLK)
unnamed: J6.2, U5.25 (SWD)
unnamed: L1.1, U14.4 (LX1), U14.5 (LX1)
unnamed: L1.2, U14.1 (LX2), U14.2 (LX2)
unnamed: L5.1, U10.27 (PA_BOOST)
unnamed: L11.1, U10.21 (RFI_HF)
unnamed: Q1.2 (G), R16.1
unnamed: Q1.3 (D), R18.2
unnamed: Q1.5 (G), R15.1
unnamed: Q1.6 (D), R17.1
unnamed: Q2.2 (G), R20.1
unnamed: Q2.3 (D), R22.2
unnamed: Q2.5 (G), R19.1
unnamed: Q2.6 (D), R21.1
unnamed: Q3.2 (G), R24.1
unnamed: Q3.3 (D), R26.2
unnamed: Q3.5 (G), R23.1
unnamed: Q3.6 (D), R25.1
unnamed: Q4.1 (D), Q4.2 (D), Q4.5 (D), Q4.6 (D), U12.6 (SOURCE), U12.7 (SOURCE)
unnamed: Q4.3 (G), U12.8 (GATE)
unnamed: R5.1, U5.47 (USB_DP)
unnamed: R6.1, U5.46 (USB_DM)
unnamed: R7.1, U3.5 (USB_DM)
unnamed: R8.1, U3.6 (USB_DP)
unnamed: R11.1, U7.3 (A2), U8.23 (SCL/SCLK)
unnamed: R12.1, U7.2 (A1), U8.24 (SDA/SDI)
unnamed: R13.2, R32.1, U2.1 (~CS), U5.56 (QSPI_SS)
unnamed: R14.2, U5.21 (XOUT)
unnamed: R28.2, R36.1, U15.4 (PR1)
unnamed: R29.2, U3.9 (VCC_RF)
unnamed: R30.2, R37.2, U15.2 (OUT), U15.7 (OUT)
unnamed: R34.1, U12.9 (EN)
unnamed: R35.2, U12.4 (ILMIT)
unnamed: SW3.2, U5.41 (GPIO29_ADC3)
unnamed: SW4.2 (B), U14.11 (EN)
unnamed: TP3.1, U3.1 (SAFEBOOT_N)
unnamed: TP4.1, U3.8 (RESET_N)
unnamed: U2.2 (DO(IO1)), U5.55 (QSPI_SD1)
unnamed: U2.3 (IO2), U5.54 (QSPI_SD2)
unnamed: U2.5 (DI(IO0)), U5.53 (QSPI_SD0)
unnamed: U2.6 (CLK), U5.52 (QSPI_SCLK)
unnamed: U2.7 (IO3), U5.51 (QSPI_SD3)
unnamed: U7.4 (A3), U8.12 (INT1)
unnamed: U10.20 (RXTX/RF_MOD), U13.4 (CRTL)

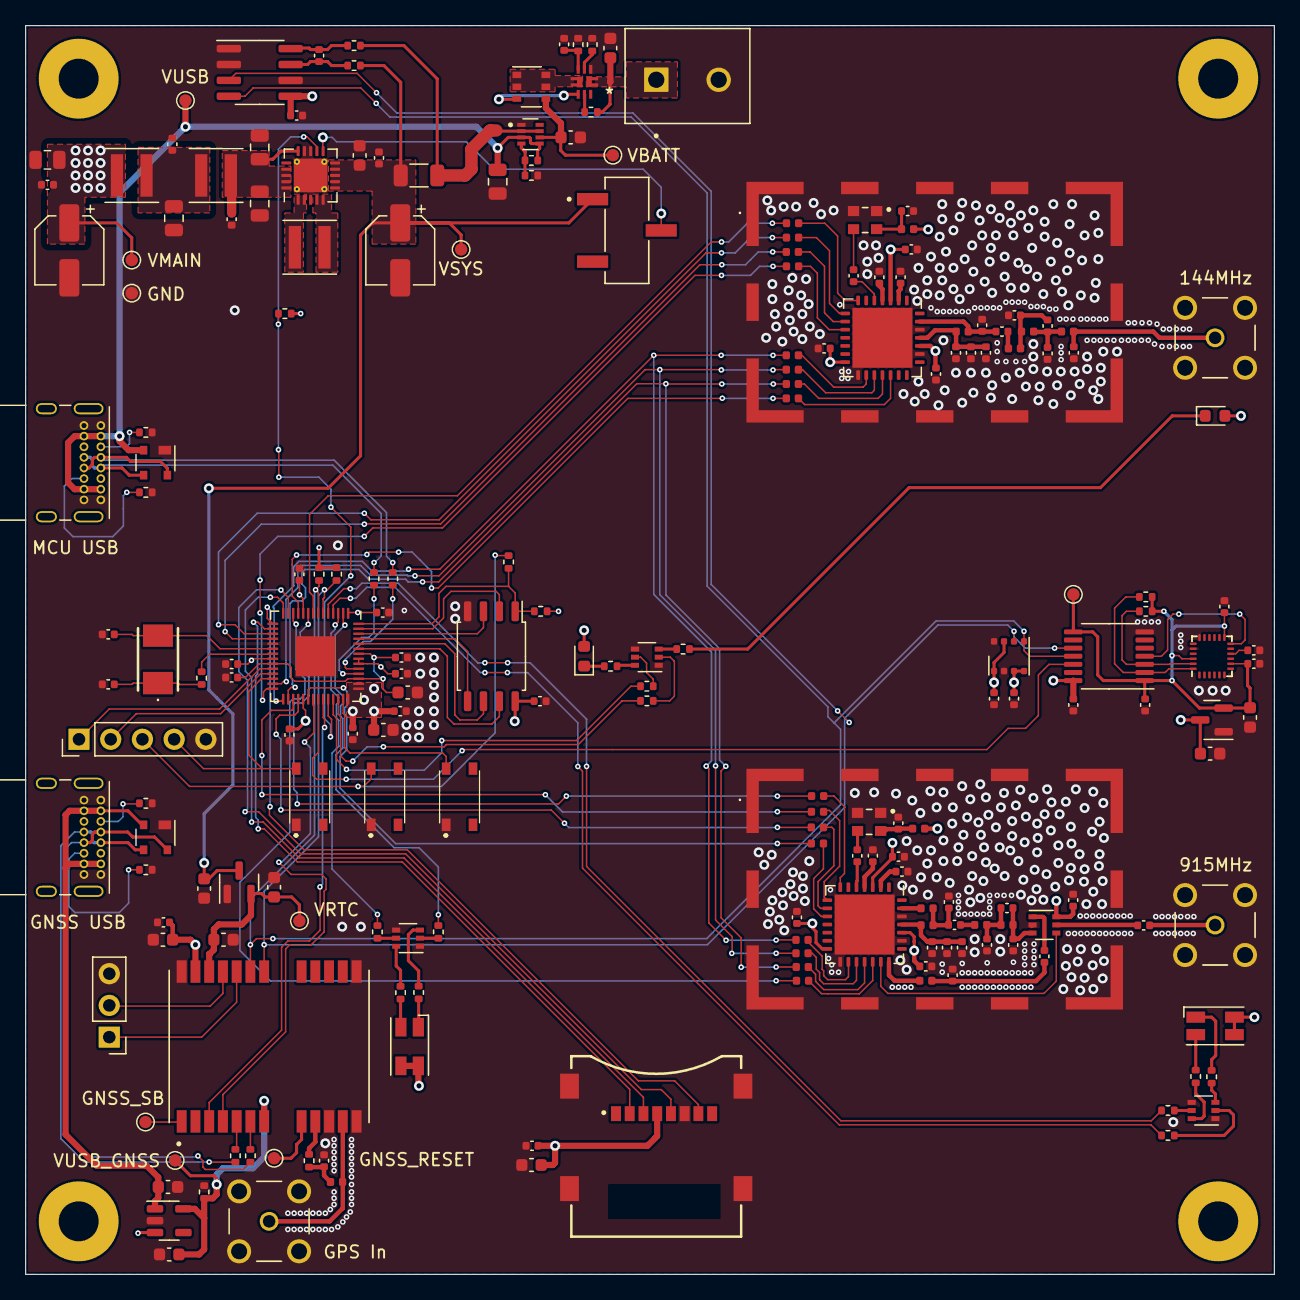
[picture p21: board HABBoard.kicad_pcb from above]

Board: 4 copper layers, 100.0 x 100.0 mm, 212 parts (0 on the bottom side), 153 nets.
