Ilikemining1/HighAltitudeBallooningBoard/(commit log)

2022-12-27 Initial commit of PCB Files
    [HABBoard.kicad_pcb, HABBoard.kicad_sch]
2022-12-28 Added GPS Module
    [HABBoard.kicad_sch]
2023-01-06 Revisions before battery change
    [HABBoard.kicad_sch]
2023-01-08 Added the rest of the sensors
    [HABBoard.kicad_sch, LBAA0QB1SJ-296.step]
2023-01-14 RF Analog Design
    [HABBoard.kicad_sch]
2023-01-16 Add I2C address allocation table
2023-01-16 More RF Stuff
    [HABBoard.kicad_sch]
2023-01-26 Last commit before sensor changes
    [ECS-TXO-25CSMV-320-BM-TR.step, HABBoard.kicad_sch, LBAA0QB1SJ-296.step]
2023-02-01 Update to BME688 sensor
    [HABBoard.kicad_sch]
2023-02-04 USB Mux Addition
    [HABBoard.kicad_sch]
2023-02-05 Added Power Switch IC, more filtering, and other stuff
    [HABBoard.kicad_sch, MEM2067-02-180-00-A_REVB.step]
2023-02-05 Final Schematic v1
    [HABBoard.kicad_sch]
2023-02-05 Final Schematic v2, begin footprint addition
    [HABBoard.kicad_sch, JS102011SCQN.step]
2023-02-06 Adding Reference Designators, again...
    [HABBoard.kicad_sch]
2023-02-06 Update Schematic PDF
    [HABBoard.kicad_sch]
2023-02-06 Added footprints and 3D models for most parts in HABParts
    [445C25D12M00000.stp, MP5016GQH.step, PTS815_SJK_250_SMTR_LFS.stp, u-blox_-_NEO-M9N-00B.step]
2023-02-06 Schematic Annotation
    [HABBoard.kicad_sch]
2023-02-07 Mostly finished footprint association
    [HABBoard.kicad_sch]
2023-02-07 Footprint assignment complete
    [CUI_DEVICES_TB002-500-02BE.step, HABBoard.kicad_sch, SMA_CONNECTOR.step]
2023-02-08 Initial PCB Layout
    [HABBoard.kicad_pcb, HABBoard.kicad_sch, USB4085-GF-A.stp]
2023-02-09 PCB Layout Work
    [BME688--3DModel-STEP-56544.STEP, HABBoard.kicad_pcb, HABBoard.kicad_sch, XFL4020-102MEC--3DModel-STEP-56544.STEP]
2023-02-12 More trace routing
    [HABBoard.kicad_pcb]
2023-02-19 More Routing
    [HABBoard.kicad_pcb, HABBoard.kicad_sch]
2023-02-23 Even more layout
    [HABBoard.kicad_pcb, HABBoard.kicad_sch]
2023-02-25 Finish majority of routing
    [HABBoard.kicad_pcb, HABBoard.kicad_sch]
2023-02-25 Fix PCB plane issues
    [HABBoard.kicad_pcb]
2023-02-25 Add Gerbers
    [HABBoard-B_Cu.gbl, HABBoard-B_Mask.gbs, HABBoard-B_Paste.gbp, HABBoard-B_Silkscreen.gbo, HABBoard-Edge_Cuts.gm1, HABBoard-F_Cu.gtl, HABBoard-F_Mask.gts, HABBoard-F_Paste.gtp]
2023-02-26 Adjust RF Layout
    [HABBoard.kicad_pcb]
2023-02-28 rearranged RF and more Via stitching
    [HABBoard.kicad_pcb]
2023-02-28 Finalize PCB Design
    [HABBoard.kicad_sch]
2023-02-28 Update Imagery and Gerbers
    [HABBoard-B_Cu.gbl, HABBoard-B_Mask.gbs, HABBoard-B_Paste.gbp, HABBoard-B_Silkscreen.gbo, HABBoard-Edge_Cuts.gm1, HABBoard-F_Cu.gtl, HABBoard-F_Mask.gts, HABBoard-F_Paste.gtp]
2023-03-02 Finalize Design Files
    [HABBoard-B_Cu.gbl, HABBoard-B_Mask.gbs, HABBoard-B_Paste.gbp, HABBoard-B_Silkscreen.gbo, HABBoard-Edge_Cuts.gm1, HABBoard-F_Cu.gtl, HABBoard-F_Mask.gts, HABBoard-F_Paste.gtp]
2023-03-14 Add BOM
